tinyvision-ai-inc/oshw-adapters/README.md

# oshw-adapters
Various adapters for GPIO, MIPI etc.
