tinyvision-ai-inc/oshw-adapters/syzygy-mipi-adapter/board/Rev1/syzygy-mipi-adapter.pdf

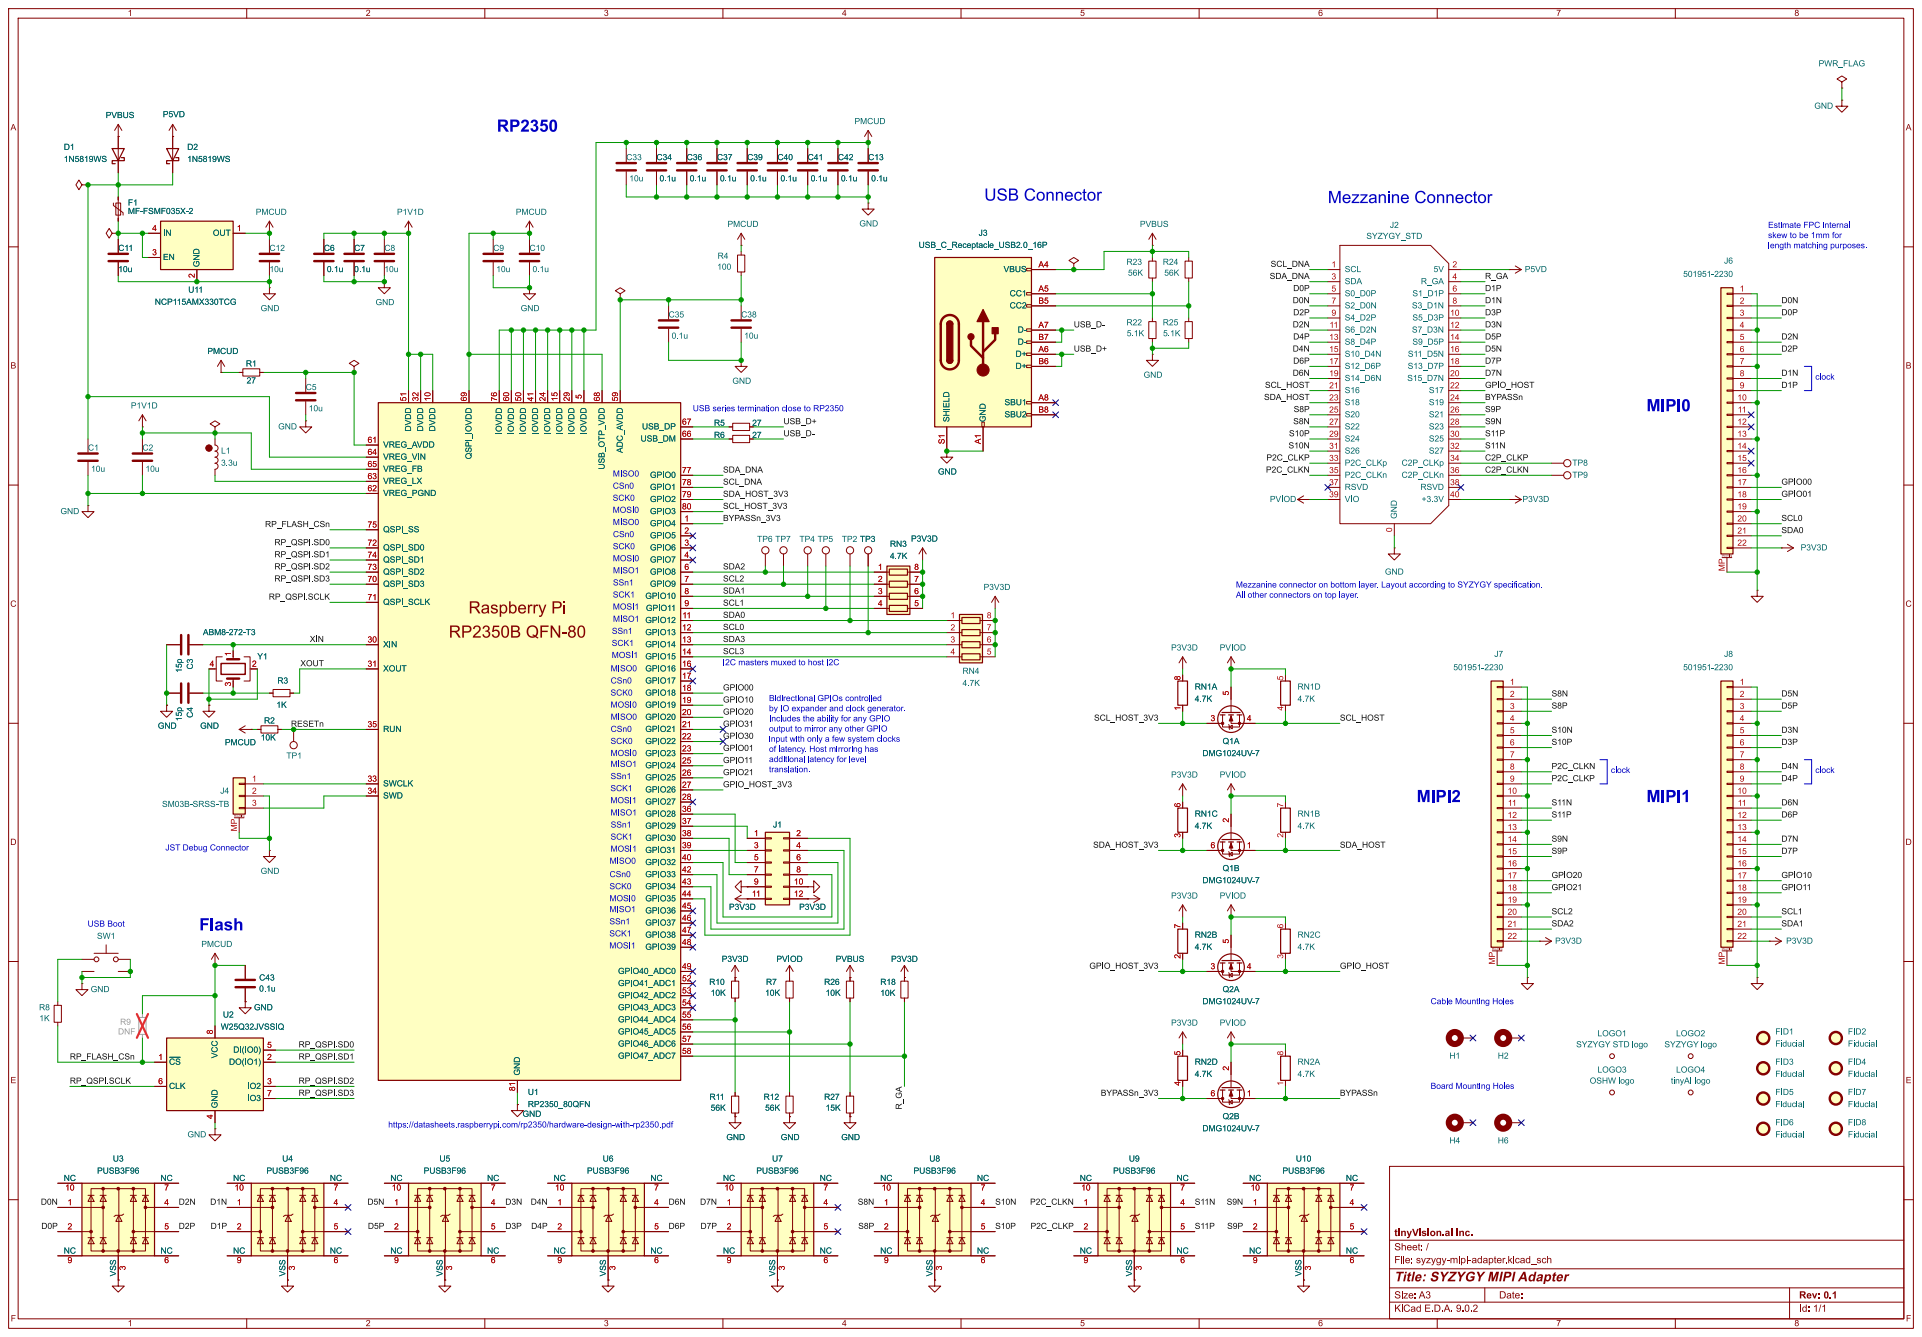
[picture p1: page 1]

Estimate FPC internal skew to be 1mm for

Mezzanine connector on bottom layer. Layout according to SYZYGY specification. All other connectors on top layer. SCK0 CSn0 Flash

by IO expander and clock generator.
Includes the ability for any GPIO
output to mirror any other GPIO
input with only a few system clocks of latency. Host mirroring has additional latency for level translation.

0.1u U3 PUSB3F96 NC
Id: 1/1 Title: SYZYGY MIPI Adapter File: syzygy-mipi-adapter.kicad_sch Sheet: / tinyVision.ai Inc. R8

FID8 Fiducial FID7 Fiducial FID1 Fiducial FID3 Fiducial

https://datasheets.raspberrypi.com/rp2350/hardware-design-with-rp2350.pdf
