tinyvision-ai-inc/oshw-adapters/syzygy-mipi-adapter/board/Rev1/syzygy-mipi-adapter.kicad_pcb

## KiCad design syzygy-mipi-adapter/board/Rev1/syzygy-mipi-adapter.kicad_pcb (2025-11-05)

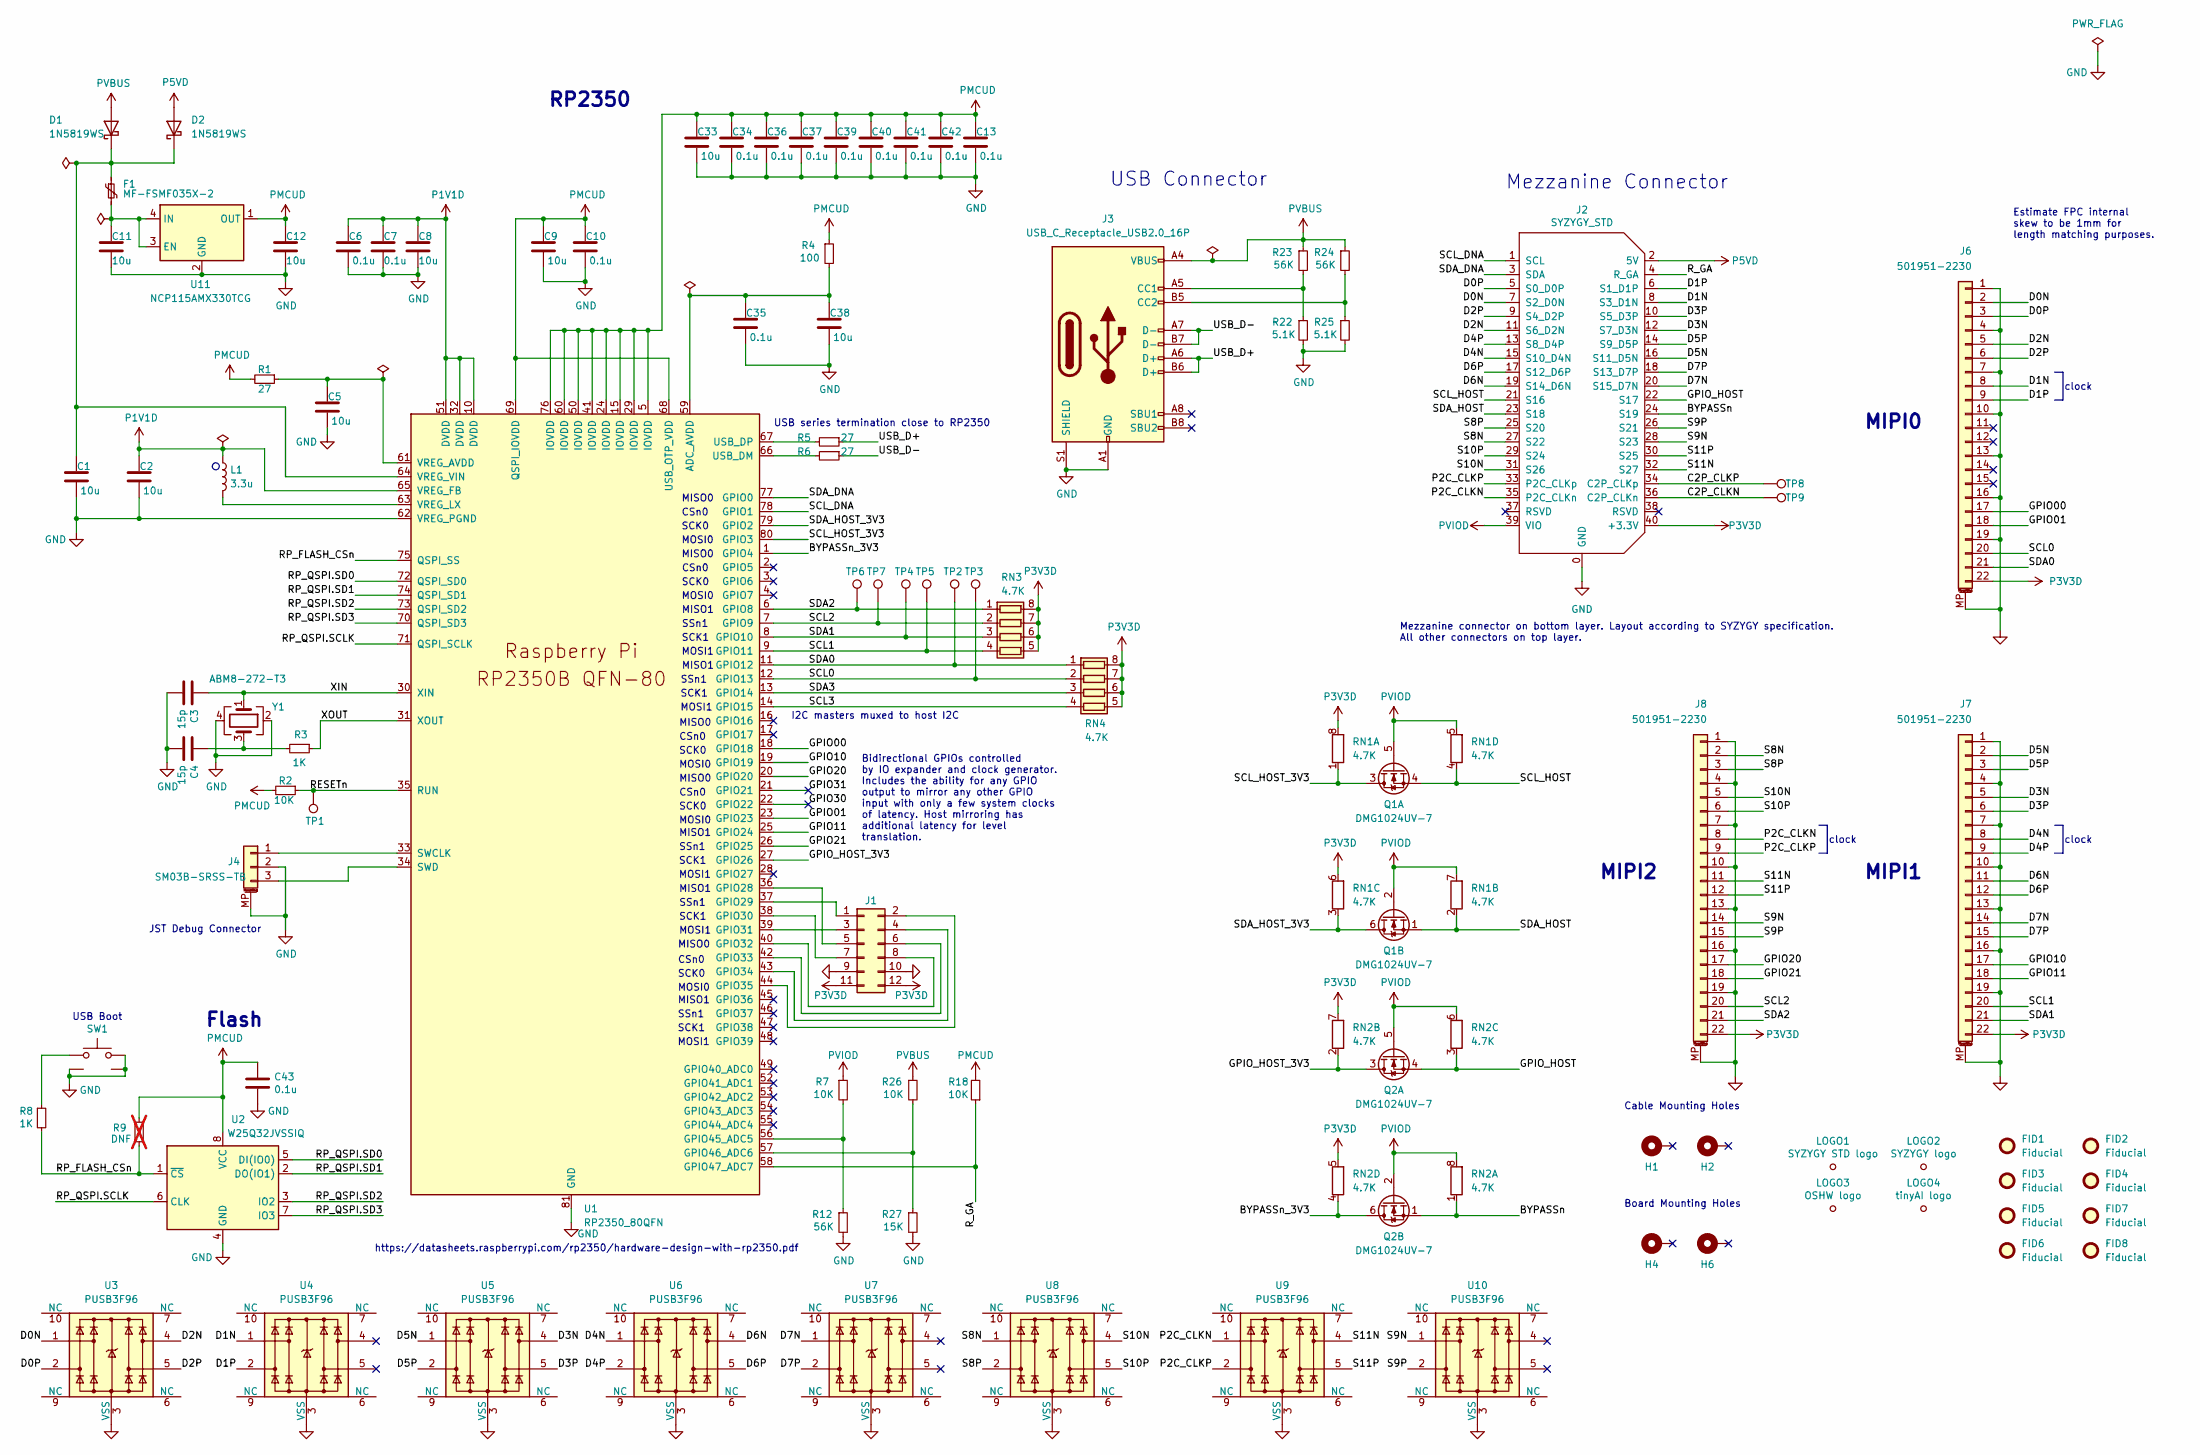
[picture p2: schematic syzygy-mipi-adapter.kicad_sch, SYZYGY MIPI Adapter]

Parts:
C1, C2, C5, C8, C9, C11, C12, C33: 10u; C_0402_1005Metric; MPN GRM155R60J475ME87D
C3, C4: 15p; C_0201_0603Metric; MPN GRM1555C1E150JA01D
C6, C7, C10, C13, C34, C35, C36, C37, C39, C40, C41, C42, C43: 0.1u; C_0201_0603Metric; MPN GRM155R71C104KA88J
C38: 10u; C_0402_1005Metric; MPN GRM155R71C104KA88J
D1, D2: 1N5819WS; D_SOD-323
F1: MF-FSMF035X-2; R_0603_1608Metric
FID1, FID2, FID3, FID4, FID5, FID6, FID7, FID8: Fiducial; Fiducial_0.75mm_Mask1.5mm
H1, H2, H4, H6: MountingHole_Pad; MountingHole_3.2mm_M3_6.5mm_Pad_TopBottom
J1: Conn_02x06_Odd_Even; PinHeader_2x06_P2.54mm_Vertical
J2: SYZYGY_STD; QTE-020-01-F-D-A; Manufacturer_PN QTE-020-01-F-D-A
J3: USB_C_Receptacle_USB2.0_16P; USB_C_Receptacle_HRO_TYPE-C-31-M-12
J4: SM03B-SRSS-TB; JST_SH_SM03B-SRSS-TB_1x03-1MP_P1.00mm_Horizontal; MPN SM03B-SRSS-TB
J6, J7, J8: 501951-2230
L1: 3.3u; L_pol_2016; MPN MLP2016H3R3MT0S1
LOGO1: SYZYGY STD logo; SYZYGY_STD_Logo; MPN DNP; Digi-Key_PN DNP
LOGO2: SYZYGY logo; SYZYGY_Logo; MPN DNP; Digi-Key_PN DNP
LOGO3: OSHW logo; OSHW_Dual_0.1_Scale_2140; MPN DNP; Digi-Key_PN DNP
LOGO4: tinyAI logo; tinyAI_4_5mm; MPN DNP; Digi-Key_PN DNP
Q1, Q2: DMG1024UV-7; SOT-563
R1, R5, R6: 27; R_0402_1005Metric; MPN RC0402FR-0727RL
R2, R7, R26: 10K; R_0402_1005Metric; MPN RC0402FR-0727RL
R3, R8: 1K; R_0402_1005Metric; MPN RC0402FR-071KL
R4: 100; R_0402_1005Metric; MPN RC0402FR-0727RL
R9: DNF; R_0402_1005Metric; not fitted
R12, R23, R24: 56K; R_0402_1005Metric; MPN RC0402FR-0727RL
R18: 10K; R_0402_1005Metric
R22, R25: 5.1K; R_0402_1005Metric; MPN RC0402FR-0727RL
R27: 15K; R_0402_1005Metric; MPN RC0402FR-0727RL
RN1, RN2, RN3, RN4: 4.7K; R_Array_Concave_4x0402
SW1: PTS820J25KSMTRLFS
TP1, TP2, TP3, TP4, TP5, TP6, TP7, TP8, TP9: TestPoint; TestPoint_Pad_1.0x1.0mm
U1: RP2350_80QFN; RP2350B_QFN-80_EP_10.573x10.573_Pitch0.4mm
U2: W25Q32JVSSIQ; SOIC-8_5.3x5.3mm_P1.27mm; MPN W25Q32JVSSIQ
U3, U4, U5, U6, U7, U8, U9, U10: PUSB3F96; PUSB3F96X
U11: NCP115AMX330TCG; OnSemi_XDFN4-1EP_1.0x1.0mm_EP0.52x0.52mm
Y1: ABM8-272-T3; Crystal_SMD_3225-4Pin_3.2x2.5mm; MPN ABM8-272-T3

Connections:
/BYPASSn: J2.24 (S19), Q2.1 (S), RN2.1 (R1.1)
/BYPASSn_3V3: Q2.6 (D), RN2.4 (R4.1), U1.1 (GPIO4)
/C2P_CLKN: J2.36 (C2P_CLKn), TP9.1
/C2P_CLKP: J2.34 (C2P_CLKp), TP8.1
/D0N: J2.7 (S2_D0N), J6.2, U3.1
/D0P: J2.5 (S0_D0P), J6.3, U3.2
/D1N: J2.8 (S3_D1N), J6.8, U4.1
/D1P: J2.6 (S1_D1P), J6.9, U4.2
/D2N: J2.11 (S6_D2N), J6.5, U3.4
/D2P: J2.9 (S4_D2P), J6.6, U3.5
/D3N: J2.12 (S7_D3N), J7.5, U5.4
/D3P: J2.10 (S5_D3P), J7.6, U5.5
/D4N: J2.15 (S10_D4N), J7.8, U6.1
/D4P: J2.13 (S8_D4P), J7.9, U6.2
/D5N: J2.16 (S11_D5N), J7.2, U5.1
/D5P: J2.14 (S9_D5P), J7.3, U5.2
/D6N: J2.19 (S14_D6N), J7.11, U6.4
/D6P: J2.17 (S12_D6P), J7.12, U6.5
/D7N: J2.20 (S15_D7N), J7.14, U7.1
/D7P: J2.18 (S13_D7P), J7.15, U7.2
/GPIO00: J6.17, U1.18 (GPIO18)
/GPIO01: J6.18, U1.23 (GPIO23)
/GPIO10: J7.17, U1.19 (GPIO19)
/GPIO11: J7.18, U1.25 (GPIO24)
/GPIO20: J8.17, U1.20 (GPIO20)
/GPIO21: J8.18, U1.26 (GPIO25)
/GPIO30: U1.22 (GPIO22)
/GPIO31: U1.21 (GPIO21)
/GPIO_HOST: J2.22 (S17), Q2.4 (S), RN2.3 (R3.1)
/GPIO_HOST_3V3: Q2.3 (D), RN2.2 (R2.1), U1.27 (GPIO26)
/P2C_CLKN: J2.35 (P2C_CLKn), J8.8, U9.1
/P2C_CLKP: J2.33 (P2C_CLKp), J8.9, U9.2
/RESETn: R2.1, TP1.1, U1.35 (RUN)
/RP_FLASH_CSn: R8.2, R9.1, U1.75 (QSPI_SS), U2.1 (~CS)
/RP_QSPI.SCLK: U1.71 (QSPI_SCLK), U2.6 (CLK)
/RP_QSPI.SD0: U1.72 (QSPI_SD0), U2.5 (DI(IO0))
/RP_QSPI.SD1: U1.74 (QSPI_SD1), U2.2 (DO(IO1))
/RP_QSPI.SD2: U1.73 (QSPI_SD2), U2.3 (IO2)
/RP_QSPI.SD3: U1.70 (QSPI_SD3), U2.7 (IO3)
/R_GA: J2.4 (R_GA), R18.1, U1.58 (GPIO47_ADC7)
/S8N: J2.27 (S22), J8.2, U8.1
/S8P: J2.25 (S20), J8.3, U8.2
/S9N: J2.28 (S23), J8.14, U10.1
/S9P: J2.26 (S21), J8.15, U10.2
/S10N: J2.31 (S26), J8.5, U8.4
/S10P: J2.29 (S24), J8.6, U8.5
/S11N: J2.32 (S27), J8.11, U9.4
/S11P: J2.30 (S25), J8.12, U9.5
/SCL0: J6.20, RN4.2 (R2.1), TP3.1, U1.12 (GPIO13)
/SCL1: J7.20, RN3.4 (R4.1), TP5.1, U1.9 (GPIO11)
/SCL2: J8.20, RN3.2 (R2.1), TP7.1, U1.7 (GPIO9)
/SCL3: RN4.4 (R4.1), U1.14 (GPIO15)
/SCL_DNA: J2.1 (SCL), U1.78 (GPIO1)
/SCL_HOST: J2.21 (S16), Q1.4 (S), RN1.4 (R4.1)
/SCL_HOST_3V3: Q1.3 (D), RN1.1 (R1.1), U1.80 (GPIO3)
/SDA0: J6.21, RN4.1 (R1.1), TP2.1, U1.11 (GPIO12)
/SDA1: J7.21, RN3.3 (R3.1), TP4.1, U1.8 (GPIO10)
/SDA2: J8.21, RN3.1 (R1.1), TP6.1, U1.6 (GPIO8)
/SDA3: RN4.3 (R3.1), U1.13 (GPIO14)
/SDA_DNA: J2.3 (SDA), U1.77 (GPIO0)
/SDA_HOST: J2.23 (S18), Q1.1 (S), RN1.2 (R2.1)
/SDA_HOST_3V3: Q1.6 (D), RN1.3 (R3.1), U1.79 (GPIO2)
/USB_D+: J3.A6 (D+), J3.B6 (D+), R5.1
/USB_D-: J3.A7 (D-), J3.B7 (D-), R6.1
/XIN: C3.1, U1.30 (XIN), Y1.1
/XOUT: R3.1, U1.31 (XOUT)
GND: C1.2, C2.2, C3.2, C4.2, C5.2, C6.2, C7.2, C8.2, C9.2, C10.2, C11.2, C12.2, C13.2, C33.2, C34.2, C35.2, C36.2, C37.2, C38.2, C39.2, C40.2, C41.2, C42.2, C43.2, J1.9, J1.10, J2.0 (GND), J3.A1 (GND), J3.A12 (GND), J3.B1 (GND), J3.B12 (GND), J3.S1 (SHIELD), J4.2, J4.MP (MountPin), J6.1, J6.4, J6.7, J6.10, J6.13, J6.16, J6.19, J6.MP (MountPin), J7.1, J7.4, J7.7, J7.10, J7.13, J7.16, J7.19, J7.MP (MountPin), J8.1, J8.4, J8.7, J8.10, J8.13, J8.16, J8.19, J8.MP (MountPin), R12.2, R22.2, R25.2, R27.2, SW1.1, SW1.SH1, SW1.SH2, U1.62 (VREG_PGND), U1.81 (GND), U2.4 (GND), U3.3 (VSS), U3.8 (VSS), U4.3 (VSS), U4.8 (VSS), U5.3 (VSS), U5.8 (VSS), U6.3 (VSS), U6.8 (VSS), U7.3 (VSS), U7.8 (VSS), U8.3 (VSS), U8.8 (VSS), U9.3 (VSS), U9.8 (VSS), U10.3 (VSS), U10.8 (VSS), U11.2 (GND), U11.5 (GND), Y1.2, Y1.4
unnamed: C4.1, R3.2, Y1.3
unnamed: C1.1, D1.1 (K), D2.1 (K), F1.1, U1.64 (VREG_VIN)
unnamed: J1.1, U1.37 (GPIO29)
unnamed: J1.2, U1.44 (GPIO35)
unnamed: J1.3, U1.39 (GPIO31)
unnamed: J1.4, U1.43 (GPIO34)
unnamed: J1.5, U1.36 (GPIO28)
unnamed: J1.6, U1.42 (GPIO33)
unnamed: J1.7, U1.38 (GPIO30)
unnamed: J1.8, U1.40 (GPIO32)
unnamed: J3.A5 (CC1), R22.1, R23.2
unnamed: J3.B5 (CC2), R24.2, R25.1
unnamed: J4.1, U1.33 (SWCLK)
unnamed: J4.3, U1.34 (SWD)
unnamed: R8.1, SW1.2
unnamed: C35.1, C38.1, R4.2, U1.59 (ADC_AVDD)
unnamed: R7.2, R12.1, U1.56 (GPIO45_ADC5)
unnamed: R26.2, R27.1, U1.57 (GPIO46_ADC6)
unnamed: R6.2, U1.66 (USB_DM)
unnamed: R5.2, U1.67 (USB_DP)
unnamed: C5.1, R1.1, U1.61 (VREG_AVDD)
unnamed: L1.2, U1.63 (VREG_LX)
unnamed: C11.1, F1.2, U11.3 (EN), U11.4 (IN)
P1V1D: C2.1, C6.1, C7.1, C8.1, L1.1, U1.10 (DVDD), U1.32 (DVDD), U1.51 (DVDD), U1.65 (VREG_FB)
P3V3D: J1.11, J1.12, J2.40 (+3.3V), J6.22, J7.22, J8.22, RN1.6 (R3.2), RN1.8 (R1.2), RN2.5 (R4.2), RN2.7 (R2.2), RN3.5 (R4.2), RN3.6 (R3.2), RN3.7 (R2.2), RN3.8 (R1.2), RN4.5 (R4.2), RN4.6 (R3.2), RN4.7 (R2.2), RN4.8 (R1.2)
P5VD: D2.2 (A), J2.2 (5V)
PMCUD: C9.1, C10.1, C12.1, C13.1, C33.1, C34.1, C36.1, C37.1, C39.1, C40.1, C41.1, C42.1, C43.1, R1.2, R2.2, R4.1, R9.2, R18.2, U1.5 (IOVDD), U1.15 (IOVDD), U1.24 (IOVDD), U1.29 (IOVDD), U1.41 (IOVDD), U1.50 (IOVDD), U1.60 (IOVDD), U1.68 (USB_OTP_VDD), U1.69 (QSPI_IOVDD), U1.76 (IOVDD), U2.8 (VCC), U11.1 (OUT)
PVBUS: D1.2 (A), J3.A4 (VBUS), J3.A9 (VBUS), J3.B4 (VBUS), J3.B9 (VBUS), R23.1, R24.1, R26.1
PVIOD: J2.39 (VIO), Q1.2 (G), Q1.5 (G), Q2.2 (G), Q2.5 (G), R7.1, RN1.5 (R4.2), RN1.7 (R2.2), RN2.6 (R3.2), RN2.8 (R1.2)

Notes on the sheet:
USB Boot
SSn1
RP2350
MISO0
SCK1
I2C masters muxed to host I2C
MISO1
MIPI0
CSn0
MOSI1
MOSI0
MIPI2
Board Mounting Holes
Estimate FPC internal skew to be 1mm for length matching purposes.
clock
USB Connector
Bidirectional GPIOs controlled by IO expander and clock generator. Includes the ability for any GPIO output to mirror any other GPIO input with only a few system clocks of latency. Host mirroring has additional latency for level translation.
SCK0
Flash
Mezzanine connector on bottom layer. Layout according to SYZYGY specification. All other connectors on top layer.
JST Debug Connector
Mezzanine Connector
Cable Mounting Holes
USB series termination close to RP2350
https://datasheets.raspberrypi.com/rp2350/hardware-design-with-rp2350.pdf
MIPI1

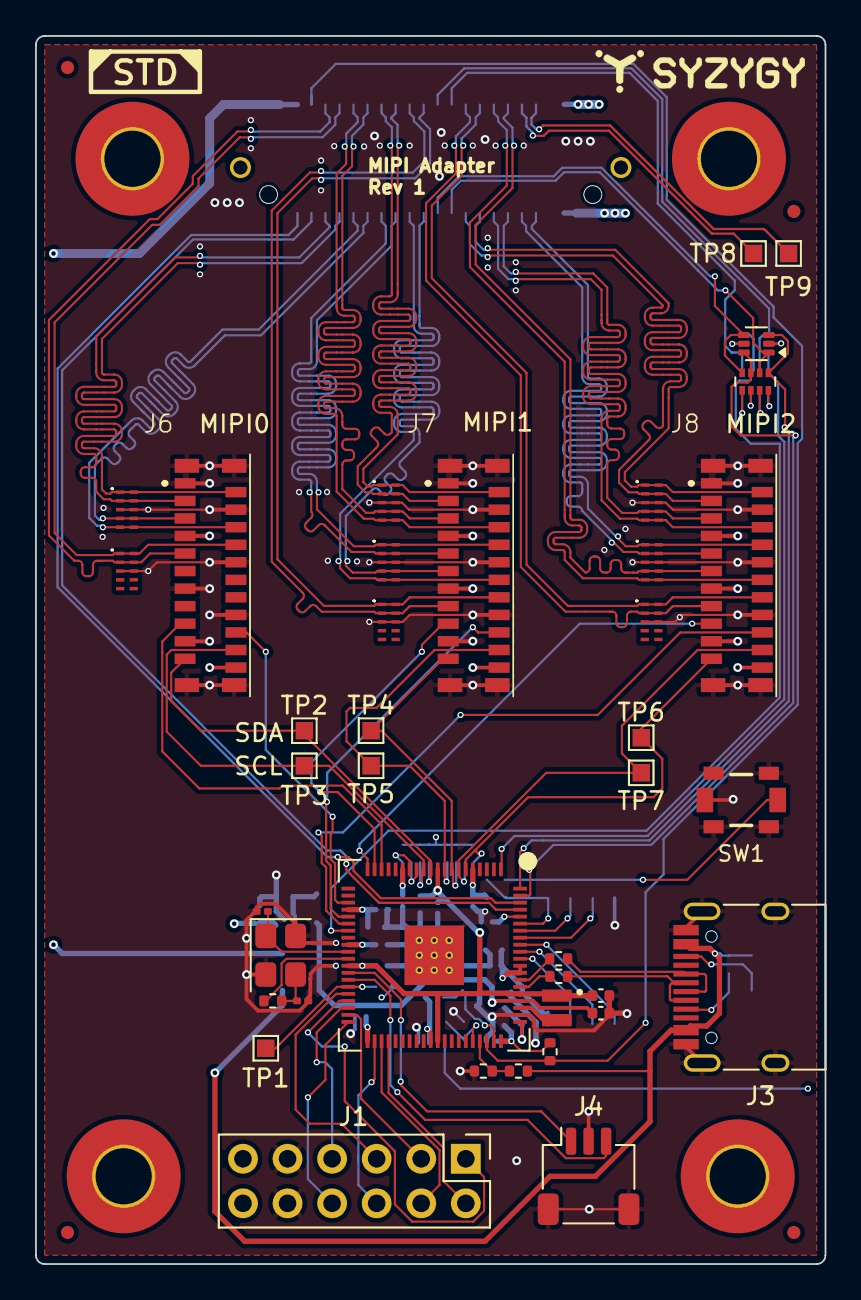
[picture p3: board syzygy-mipi-adapter.kicad_pcb from above]

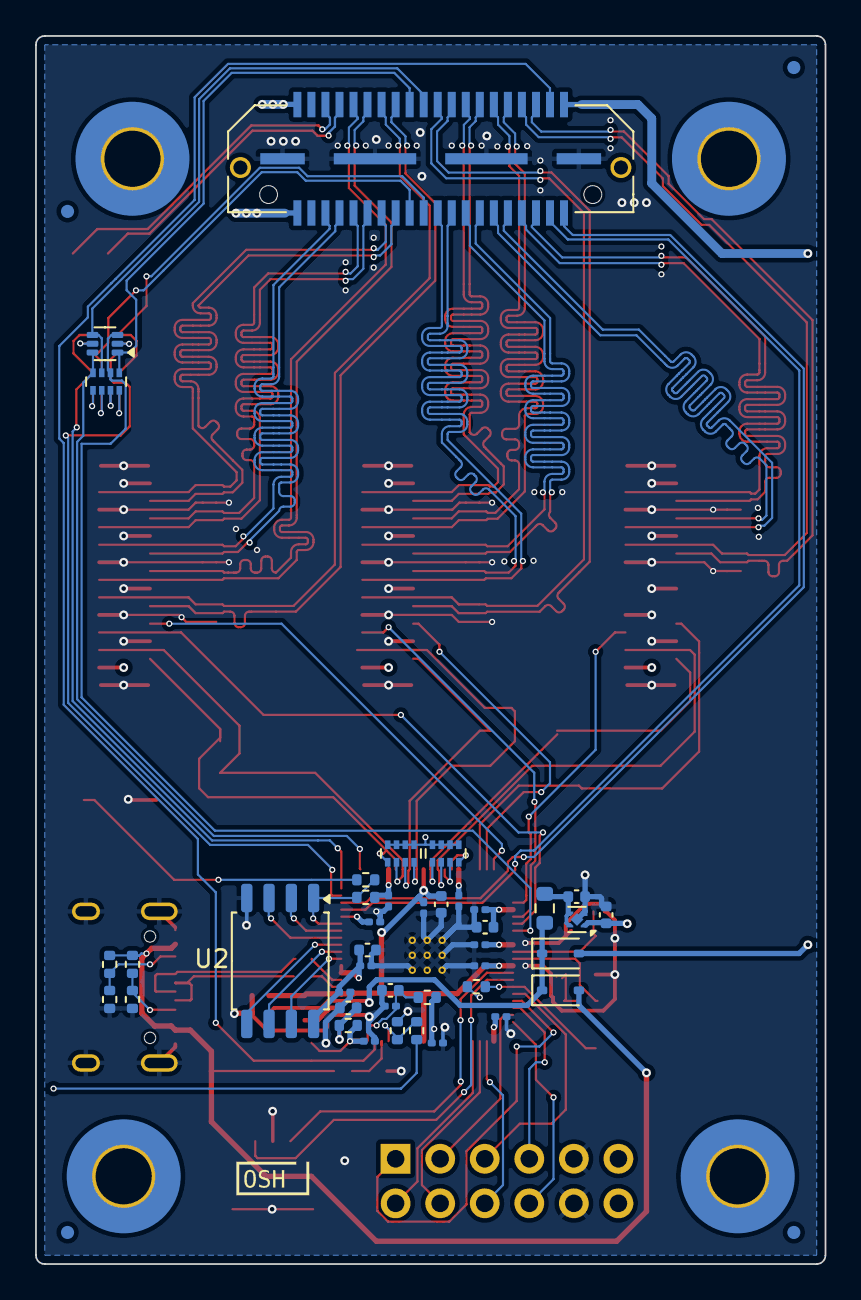
[picture p4: board syzygy-mipi-adapter.kicad_pcb from below]

Board: 4 copper layers, 45.0 x 70.0 mm, 96 parts (45 on the bottom side), 94 nets.
