tinyvision-ai-inc/oshw-adapters/(commit log)

2025-08-24 initial version
    [Connectors.kicad_sch, FPGA.kicad_sch, Power.kicad_sch, RP2350.kicad_sch, syzygy-mipi-adapter.kicad_pcb, syzygy-mipi-adapter.kicad_sch]
2025-08-26 Plot schematic
2025-08-26 Restore accidentally deleted mounting hole
    [syzygy-mipi-adapter.kicad_pcb]
2025-08-26 Fix length matching of diff pair
    [syzygy-mipi-adapter.kicad_pcb]
2025-08-27 Fix fill zones
    [syzygy-mipi-adapter.kicad_pcb]
2025-08-28 Add USB connector and 3.3V regulator to Syzygy MIPI adapter
    [syzygy-mipi-adapter.kicad_pcb, syzygy-mipi-adapter.kicad_sch]
2025-08-28 Fix schematic ERC errors for Syzygy MIPI adapter
    [syzygy-mipi-adapter.kicad_sch]
2025-08-28 Add USB connector and 3.3V regulator
    [syzygy-mipi-adapter.kicad_pcb, syzygy-mipi-adapter.kicad_sch]
2025-08-29 Add I2C test pads
    [syzygy-mipi-adapter.kicad_pcb, syzygy-mipi-adapter.kicad_sch]
2025-09-01 Cut out power planes under differential pair pads
    [syzygy-mipi-adapter.kicad_pcb]
2025-09-01 Oscillator ground shielding. Improve USB routing.
    [syzygy-mipi-adapter.kicad_pcb]
2025-09-02 Sort out decoupling caps
    [syzygy-mipi-adapter.kicad_pcb, syzygy-mipi-adapter.kicad_sch]
2025-09-02 Separate 3.3V rails for MSU vs Syzygy
    [syzygy-mipi-adapter.kicad_pcb, syzygy-mipi-adapter.kicad_sch]
2025-09-02 Added test points for otherwise unconnected Syzygy pins
    [syzygy-mipi-adapter.kicad_pcb, syzygy-mipi-adapter.kicad_sch]
2025-09-02 Refill zones
    [syzygy-mipi-adapter.kicad_pcb]
2025-09-02 Remove P5VD trace between Syzygy connector and left fill to open up 3.3V plane
    [syzygy-mipi-adapter.kicad_pcb]
2025-09-02 Reduce length of PVIOD trace between Syzygy connector and right fill to open up 3.3V plane
    [syzygy-mipi-adapter.kicad_pcb]
2025-09-02 Update fills
    [syzygy-mipi-adapter.kicad_pcb]
2025-09-04 Update stack-up. Adjust DP trace width and spacing to 100 ohm impedance.
    [syzygy-mipi-adapter.kicad_pcb]
2025-09-04 Replace only 2.2u cap with 10u
    [syzygy-mipi-adapter.kicad_sch]
2025-09-04 Made tinyvision logo bigger
    [syzygy-mipi-adapter.kicad_pcb, syzygy-mipi-adapter.kicad_sch]
2025-09-06 Add a few more vias
    [syzygy-mipi-adapter.kicad_pcb]
2025-11-05 Move files to board/Rev0
    [Connectors.kicad_sch, FPGA.kicad_sch, Power.kicad_sch, RP2350.kicad_sch, syzygy-mipi-adapter.kicad_pcb, syzygy-mipi-adapter.kicad_sch]
2025-11-05 Rev 1 of Syzygy MIPI adapter (currently just a copy of Rev 0)
    [Connectors.kicad_sch, FPGA.kicad_sch, Power.kicad_sch, RP2350.kicad_sch, syzygy-mipi-adapter.kicad_pcb, syzygy-mipi-adapter.kicad_sch]
2025-11-05 Consolidate footprints from several footprint libraries into CUSTOM.pretty
    [syzygy-mipi-adapter.kicad_pcb, syzygy-mipi-adapter.kicad_sch]
2025-11-05 Fix issue #5 as described in that issue
    [syzygy-mipi-adapter.kicad_pcb, syzygy-mipi-adapter.kicad_sch]
2025-11-05 Fix issue #7
    [syzygy-mipi-adapter.kicad_pcb]
2025-11-05 Fix issue #6 and other silkscreen issues. Moved I2C test points a bit further away from FPCs.
    [syzygy-mipi-adapter.kicad_pcb]
